rodan/rusia_neagra/README

power supply assy redesign for the Rusia Neagra MKII amplifier made by VIOTUBEAMP

https://www.tehnium-azi.ro/forums/topic/6689-proiectul-nr49-amplificatorul-rusia-neagra/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

pictures of the build are available here:
https://photos.app.goo.gl/SxAB8hwyef6rpiTH7
