rodan/rusia_neagra/ir/rusia_neagra_mk2_02.pdf

SIMPLEX | Titlul lucrării: Înregistrări termografice amplificator Rusia Neagra MKII feb 2020 | pag. 1
cod lucrare: CJ-01-20 | | actualizare 0

1

## BULETIN TERMOGRAFIC

T01 – 01 – CJ 01

SIMPLEX | pag. 2
feb 2020
| 0

2

low voltage power filter – the warm part is the full bridge rectifier

Ar1

23.0

40.1 °C

25

30

35

40

FLIR Systems

That pcb was replaced with a capacitor multiplier filter that also provides a tiny voltage drop that provides a much closer voltage to the ideal one needed by the valve heaters. Also the ripple was reduced from 400mV pk-pk to non-measurable levels.

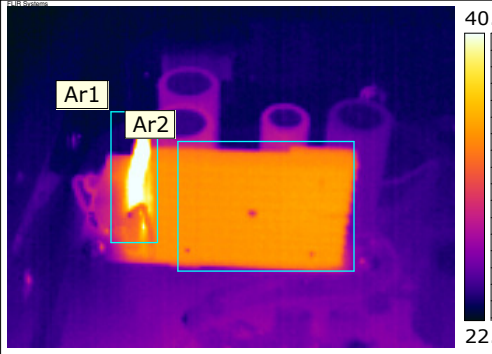
[picture p1: figure]

The hottest part is still the full bridge rectifier (Ar1 above), followed closely by the radiator (Ar2). The voltage drop of the circuit is about 1.6V.

Label | Value
IR: File Name | IR_6300.jpg
Ar1: Max | 38.1 °C
Label | Value
IR: File Name | IR_6320.jpg
IR: Max | 42.2 °C
Ar1: Max | 42.2 °C
Ar2: Max | 34.8 °C

22.8

40.0 °C

25

30

35

FLIR Systems

SIMPLEX | pag. 3
feb 2020
| 0

3

High voltage power source

The original PCB was a mosfet? based filter. Two of the resistors were found to be 70+ degrees above ambient:

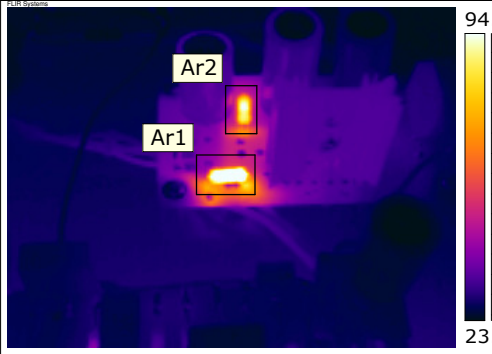
[picture p2: figure]

23.5

94.7 °C

40

60

80

FLIR Systems

It got replaced by a capacitor multiplier circuit that provides about 344V DC under load with no measurable ripple. The voltage drop between the input and the output of this circuit is about 2V, making the radiator almost redundant.

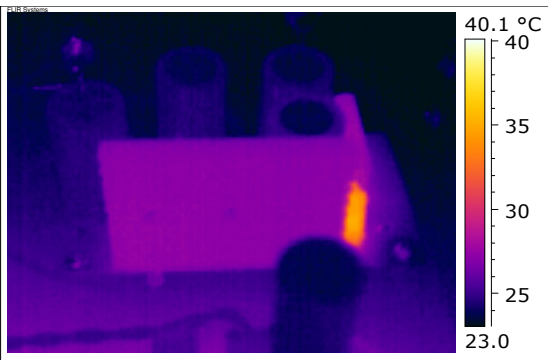
[picture p3: figure]
FLIR Systems

the hottest parts (15 degrees above ambient) are two 1Meg bleeder resistors - one placed on the input and one on the output.

Label | Value
IR: Date Of Creation | 2/9/2020
IR: Time Of Creation | 12:17:34 PM
IR: File Name | IR_6309.jpg
IR: Max | 105.4 °C
Ar1: Max | *105.5 °C
Ar2: Max | 96.1 °C
Label | Value
IR: File Name | IR_6322.jpg
IR: Max | 35.2 °C

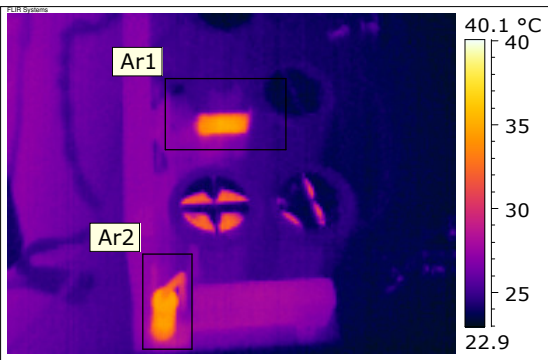
[picture p4: figure]
FLIR Systems

Label | Value
IR: File Name | IR_6321.jpg
IR: Max | 35.1 °C
Ar1: Max | 35.1 °C
Ar2: Max | 34.9 °C

SIMPLEX | pag. 4
feb 2020
| 0

4

Low wattage resistors in parallel with the triode’s heater

Sp1

23.9

52.6 °C

30

40

50

FLIR Systems

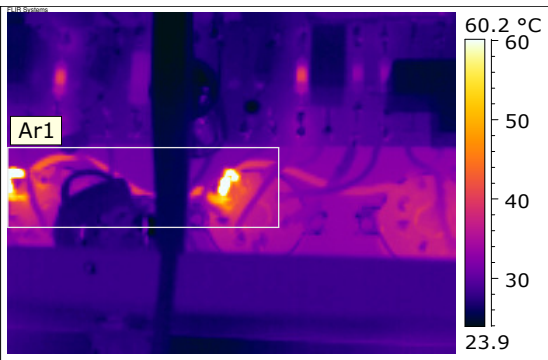
[picture p5: figure]
FLIR Systems

The 0.25W carbon resistors have been replaced with 5W wirewound ones:

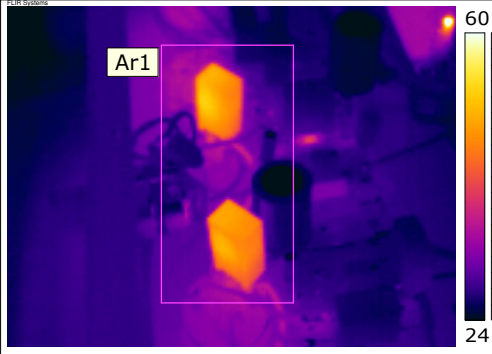
[picture p6: figure]

24.1

60.0 °C

30

40

50

FLIR Systems

Label | Value
IR: File Name | IR_6305.jpg
IR: Max | 104.9 °C
Sp1 | 103.2 °C
Label | Value
IR: File Name | IR_6306.jpg
Ar1: Max | 97.3 °C
Label | Value
IR: File Name | IR_6324.jpg
Ar1: Max | 52.8 °C

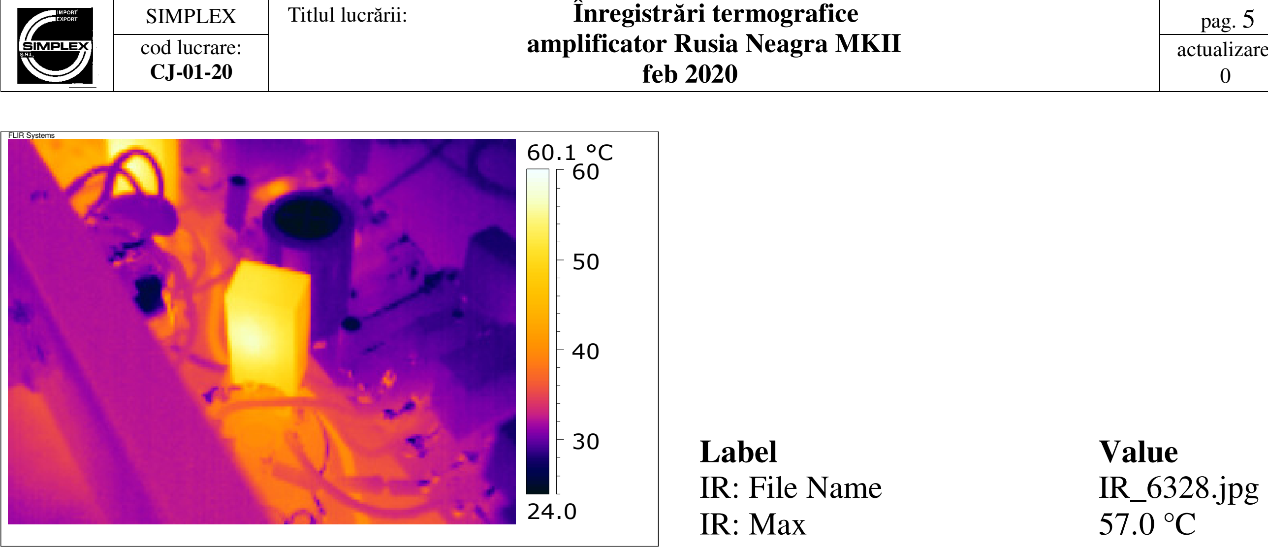
[picture p7: figure]
SIMPLEX; pag. 5; feb 2020; FLIR Systems; Label; Value; IR: File Name; IR_6328.jpg; IR: Max

5

SIMPLEX | pag. 6
feb 2020
| 0

6

LED resistors

21.2

56.2 °C

30

40

50

FLIR Systems

the 4K7 resistors were replaced with a 0.5W 47K one

Label | Value
IR: Date Of Creation | 2/9/2020
IR: Time Of Creation | 12:19:49 PM
IR: File Name | IR_6313.jpg
IR: Max | 72.0 °C
