rodan/rusia_neagra/ir/rusia_neagra_mk2_01.pdf

SIMPLEX | Titlul lucrării: Înregistrări termografice amplificator Rusia Neagra MKII feb 2020 | pag. 1
cod lucrare: CJ-01-20 | | actualizare 0

1

## BULETIN TERMOGRAFIC

T01 – 01 – CJ 01

SIMPLEX | pag. 2
feb 2020
| 0

2

low voltage power source – warm part is the full wave rectifier

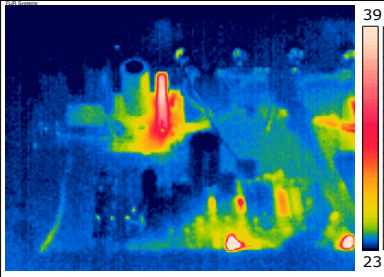
[picture p8: figure]

23.0

39.2 °C

25

30

35

FLIR Systems

high voltage power source – high wattage resistors

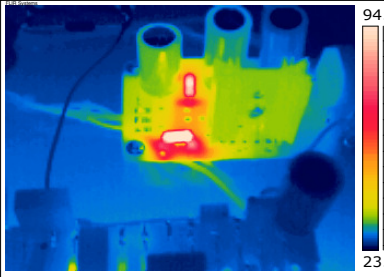
[picture p9: figure]

23.5

94.7 °C

40

60

80

FLIR Systems

low wattage resistors in parallel with the triode’s heater

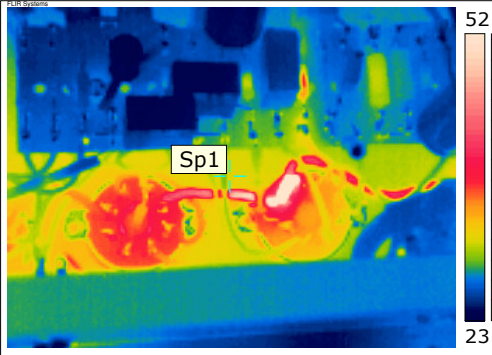
[picture p10: figure]

23.9

52.6 °C

30

40

50

FLIR Systems

Label | Value
IR: Date Of Creation | 2/9/2020
IR: Time Of Creation | 12:06:41 PM
IR: File Name | IR_6300.jpg
IR: Max | 85.7 °C
Label | Value
IR: Date Of Creation | 2/9/2020
IR: Time Of Creation | 12:17:34 PM
IR: File Name | IR_6309.jpg
IR: Max | 105.4 °C
Label | Value
IR: Date Of Creation | 2/9/2020
IR: Time Of Creation | 12:16:52 PM
IR: File Name | IR_6305.jpg
IR: Max | 104.9 °C

SIMPLEX | pag. 3
feb 2020
| 0

3

low wattage resistors in parallel with the triode’s heater

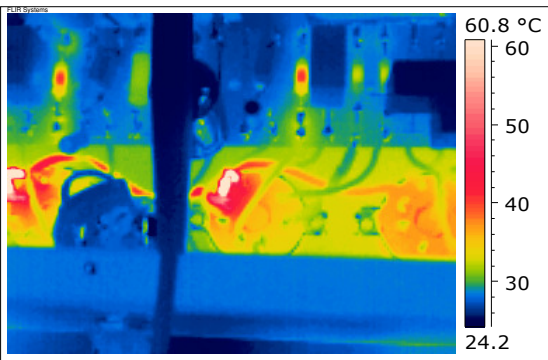
[picture p11: figure]
FLIR Systems

LED resistors

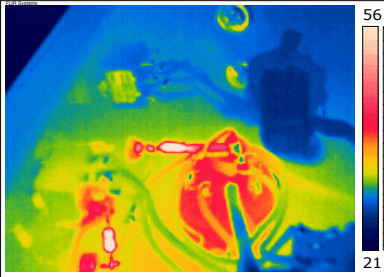
[picture p12: figure]

21.2

56.2 °C

30

40

50

FLIR Systems

Label | Value
IR: Date Of Creation | 2/9/2020
IR: Time Of Creation | 12:17:05 PM
IR: File Name | IR_6306.jpg
IR: Max | 97.3 °C
Label | Value
IR: Date Of Creation | 2/9/2020
IR: Time Of Creation | 12:19:49 PM
IR: File Name | IR_6313.jpg
IR: Max | 72.0 °C
