rodan/rusia_neagra/ltspice/ripple_filter_neg_bipolar.asc

C1: cap; 1000µ
C2: cap; 6600µ
C4: cap; 3300µ
D1: diode
Q1: pnp; BD140
Q2: pnp; 2SA1943
R1: res; 2K
R2: res; 100k
R3: res; 60
R4: res; 3K
R5: res; 10k
R6: res; 100k
V1: voltage; PULSE(39.5 38.5 0 2ms 8ms 0.01ms 10ms)
Named nets: 0, -Vin, -Vout
.tran 0 60s 59900ms
.include 2sa1943.lib
.include bd140.lib
