rodan/rusia_neagra/ltspice/ripple_filter_neg_mosfet.asc

C1: cap; 1µ
C2: cap; 4700µ
C3: cap; 220µ
D1: diode
M1: pmos; IRFP9240
R1: res; 220
R2: res; 10k
R3: res; 1.5
R4: res; 30
V1: voltage; PULSE(39.5 38.5 0 2ms 8ms 0.01ms 10ms)
Named nets: 0, -Vin, -Vout
.tran 0 10s 9940ms
