rodan/rusia_neagra/ltspice/ripple_filter_pos_bipolar.asc

C1: cap; 120µ
C2: cap; 240µ
C3: cap; 120µ
D1: diode
Q1: npn; 2SC5658
Q2: npn; BC547C
R1: res; 100k
R2: res; 22k
R3: res; 600
R4: res; 30k
R5: res; 1Meg
R6: res; 22k
V1: voltage; PULSE(320 310 0 2ms 8ms 0.01ms 10ms)
Named nets: 0, Vin, Vout
.tran 0 10s 9960ms
