rodan/rusia_neagra/ltspice/original_filter.asc

C1: cap; 100µ
C2: cap; 68µ
D1: zener; BZX84C12L
M1: nmos; IRFP240
R1: res; 650k
R3: res; 30k
R4: res; 100k
V1: voltage; PULSE(345 340 0 20ms 80ms 0 100ms)
Named nets: 0, Vin, Vout
.tran 0 10s 9500ms
