rodan/rusia_neagra/ltspice/ripple_filter_pos_mosfet.asc

C1: cap; 220µ
C2: cap; 4700µ
C3: cap; 1µ
D1: diode
M1: nmos; IRFP240
R1: res; 10K
R2: res; 220
R3: res; 20
R4: res; 1.5
V1: voltage; PULSE(18 21 0 2ms 8ms 0.01ms 10ms)
Named nets: 0, Vin, Vout
.tran 0 10s 9960ms
