rodan/rusia_neagra/pwr_pos_bipolar.brd

## EAGLE design pwr_pos_bipolar.brd (2020-05-01)

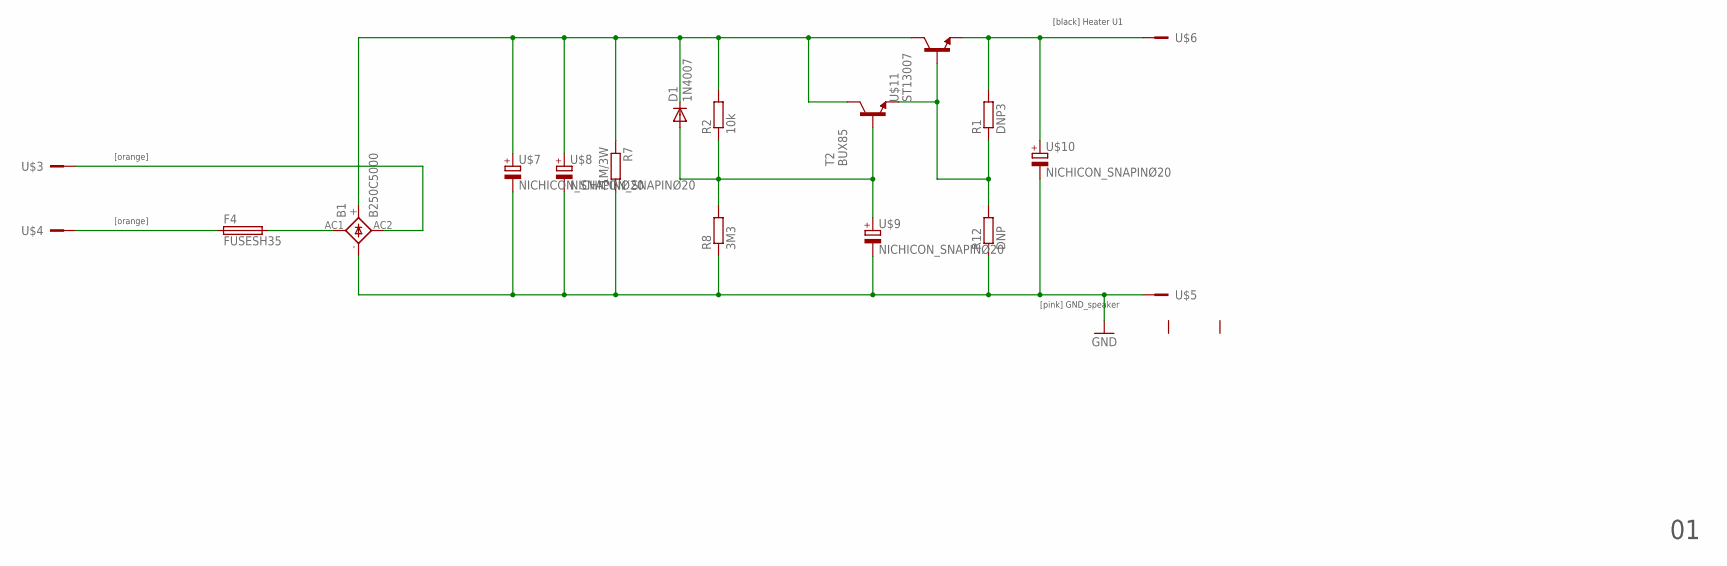
[picture p13: schematic pwr_pos_bipolar.sch, Power Assy - Positive bipolar]

Parts:
B1: B250C5000; DIOTEC_BC5000
D1: 1N4007; DO41-10
F4: FUSESH35; SH25
R1: DNP3; 0411/12
R2: 10k; 0411/12
R7: 1M/3W; 0922V
R8: 3M3; 0411/12
R12: DNP; 0411/12
T2: BUX85; TO220V
U$1: SK456-60-3XM3L
U$2: RN_POWER; RN
U$3, U$4, U$5, U$6: M1; M1_OFFSET
U$7, U$8, U$9, U$10: NICHICON_SNAPINØ20; C_20G10
U$11: ST13007; TOP3V_TO220

Connections:
30VAC_1: B1.AC2, U$3.1
30VAC_2: F4.1, U$4.1
GND: B1.-, R7.2, R8.1, R12.1, U$5.1, U$7.-, U$8.-, U$9.-, U$10.-
unnamed: B1.AC1, F4.2
unnamed: R1.1, R12.2, T2.3 (E), U$11.B, U$11.B$1 (B)
unnamed: D1.A, R2.1, R8.2, T2.1 (B), U$9.+
N_C: B1.+, D1.C, R2.2, R7.1, T2.2 (C), U$7.+, U$8.+, U$11.C
V-: R1.2, U$6.1, U$10.+, U$11.E, U$11.E$1 (E)

Notes on the sheet:
[orange]
[pink] GND_speaker
[black] Heater U1

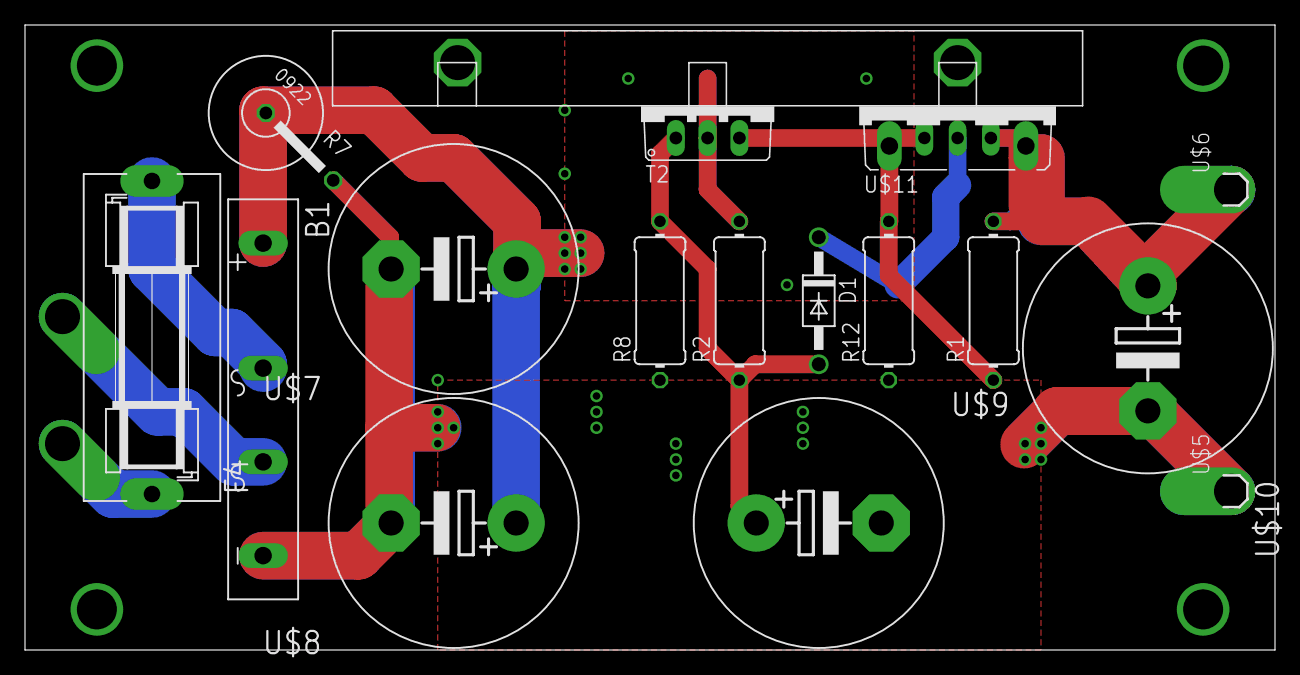
[picture p14: board pwr_pos_bipolar.brd from above]

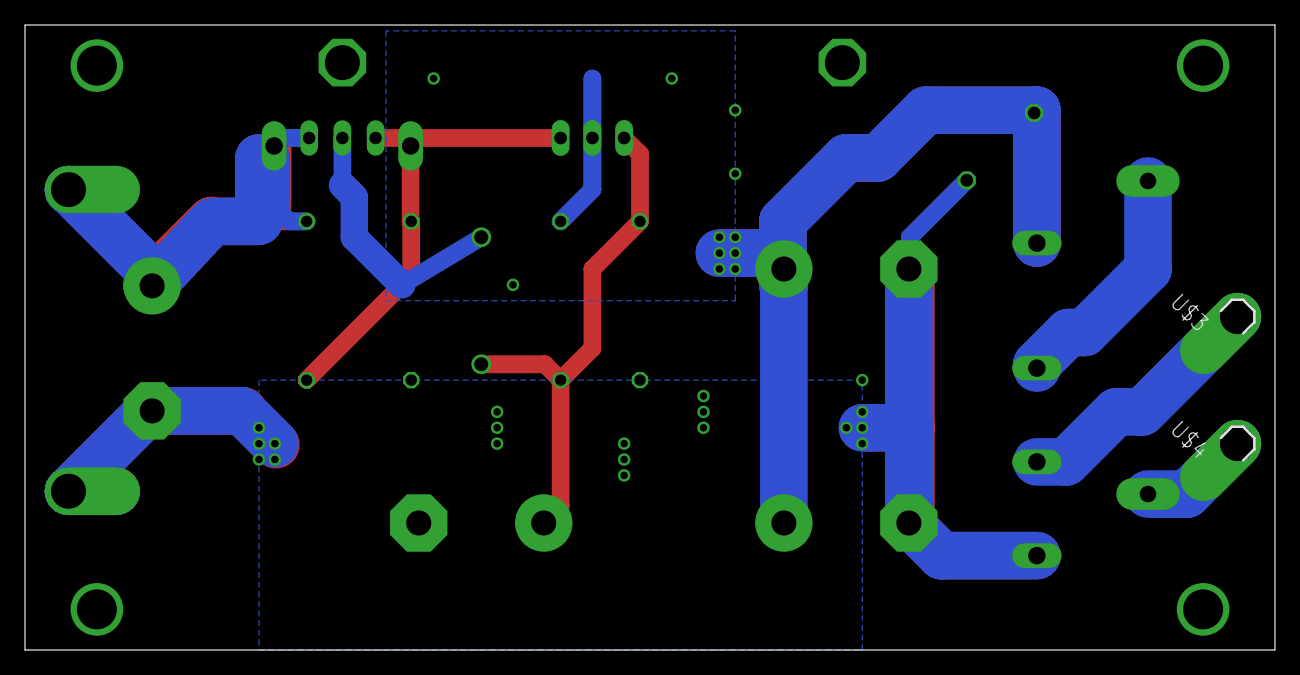
[picture p15: board pwr_pos_bipolar.brd from below]

Board: 2 copper layers, 100.0 x 50.0 mm, 20 parts (2 on the bottom side), 8 nets.
