rodan/rusia_neagra/pwr_neg_bipolar.brd

## EAGLE design pwr_neg_bipolar.brd (2020-04-26)

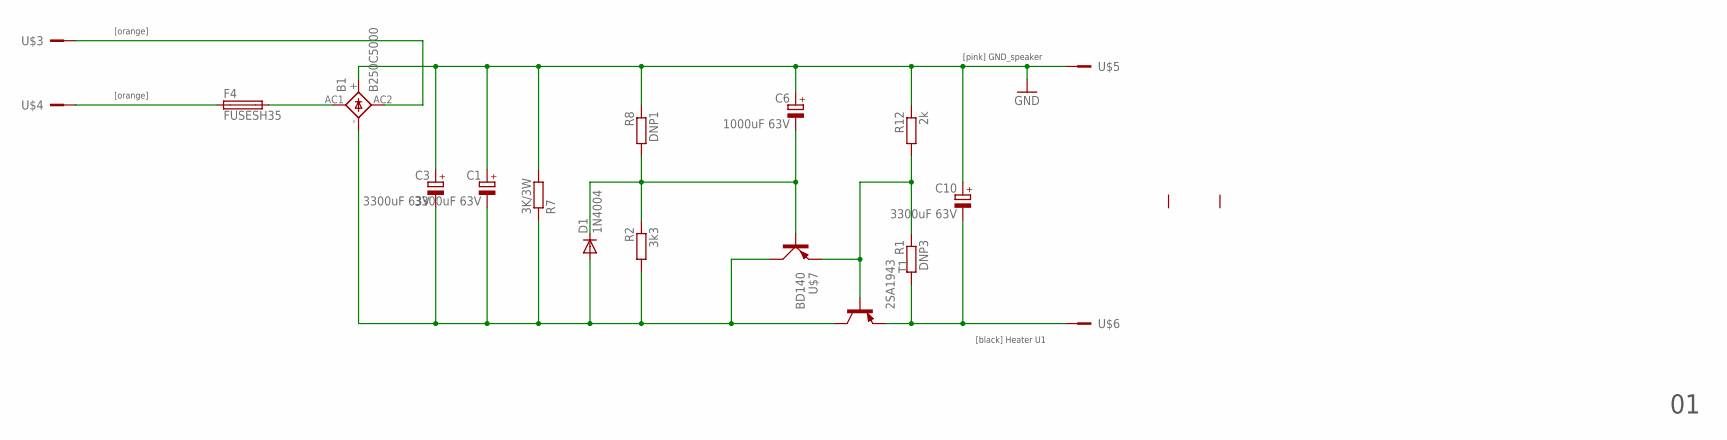
[picture p16: schematic pwr_neg_bipolar.sch, Power Assy - negative bipolar]

Parts:
B1: B250C5000; DIOTEC_BC5000
C1, C3, C10: 3300uF 63V; EB20D
C6: 1000uF 63V; E7,5-16
D1: 1N4004; DO41-10
F4: FUSESH35; SH25
R1: DNP3; 0411/12
R2: 3k3; 0411/12
R7: 3K/3W; 0922V
R8: DNP1; 0411/12
R12: 2k; 0411/12
T1: 2SA1943; TOP3V
U$1: SK456-60-3XM3L
U$2: RN_POWER; RN
U$3, U$4, U$5, U$6: M1; M1_OFFSET
U$7: BD140; SOT32

Connections:
30VAC_1: B1.AC2, U$3.1
30VAC_2: F4.1, U$4.1
GND: B1.+, C1.+, C3.+, C6.+, C10.+, R7.2, R8.1, R12.1, U$5.1
unnamed: B1.AC1, F4.2
unnamed: R1.1, R12.2, T1.B, U$7.E
unnamed: C6.-, D1.C, R2.1, R8.2, U$7.B
N_C: B1.-, C1.-, C3.-, D1.A, R2.2, R7.1, T1.C, U$7.C
V-: C10.-, R1.2, T1.E, U$6.1

Notes on the sheet:
[orange]
[pink] GND_speaker
[black] Heater U1

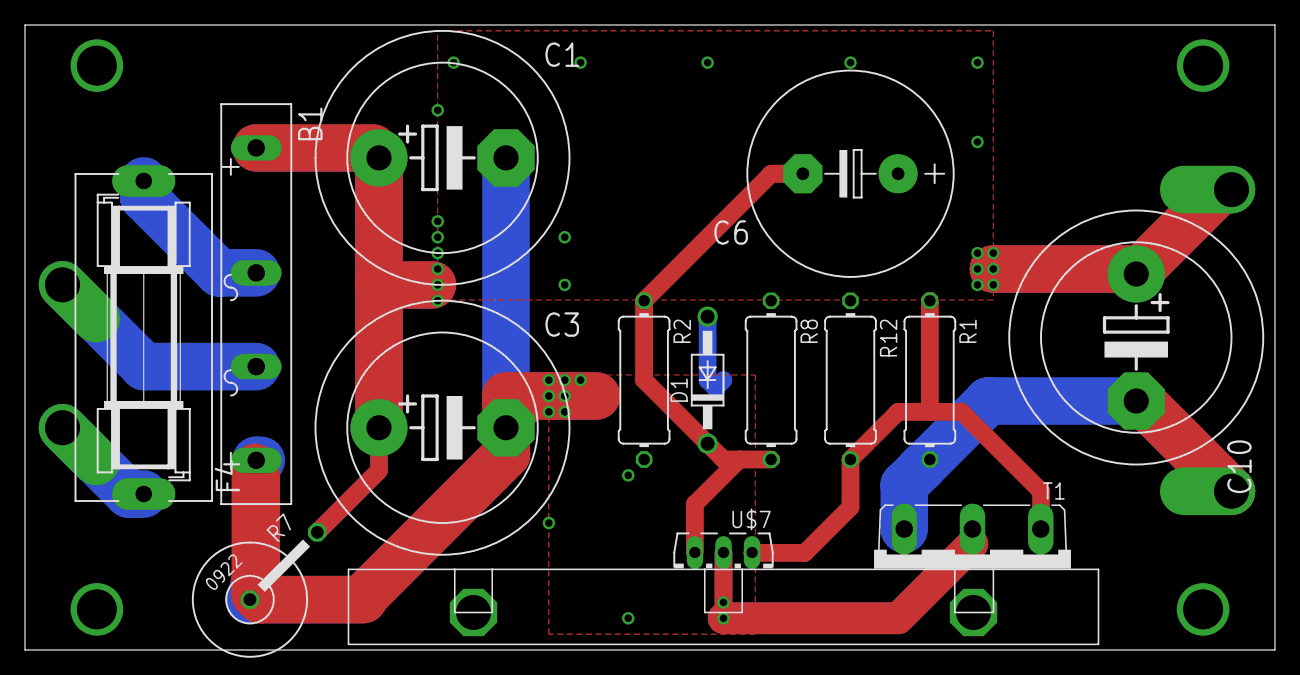
[picture p17: board pwr_neg_bipolar.brd from above]

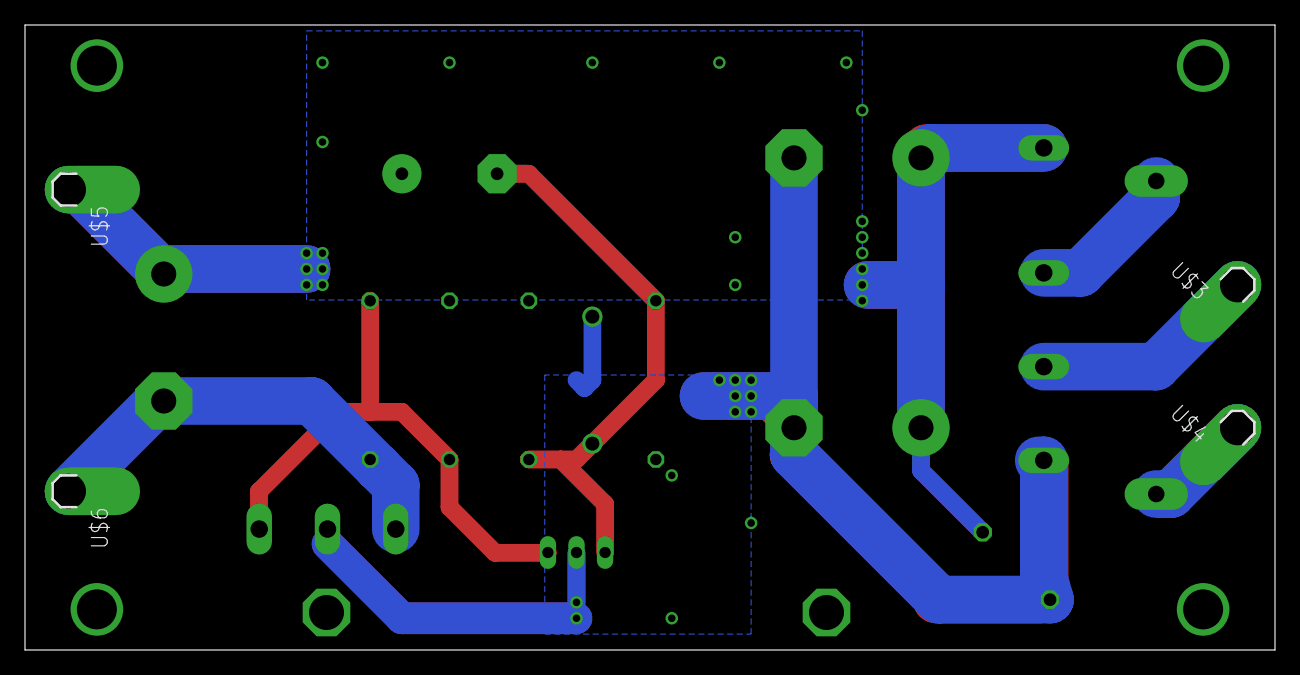
[picture p18: board pwr_neg_bipolar.brd from below]

Board: 2 copper layers, 100.0 x 50.0 mm, 20 parts (4 on the bottom side), 8 nets.
