rodan/rusia_neagra/rn_mk2.brd

## EAGLE design rn_mk2.brd (2020-03-02)

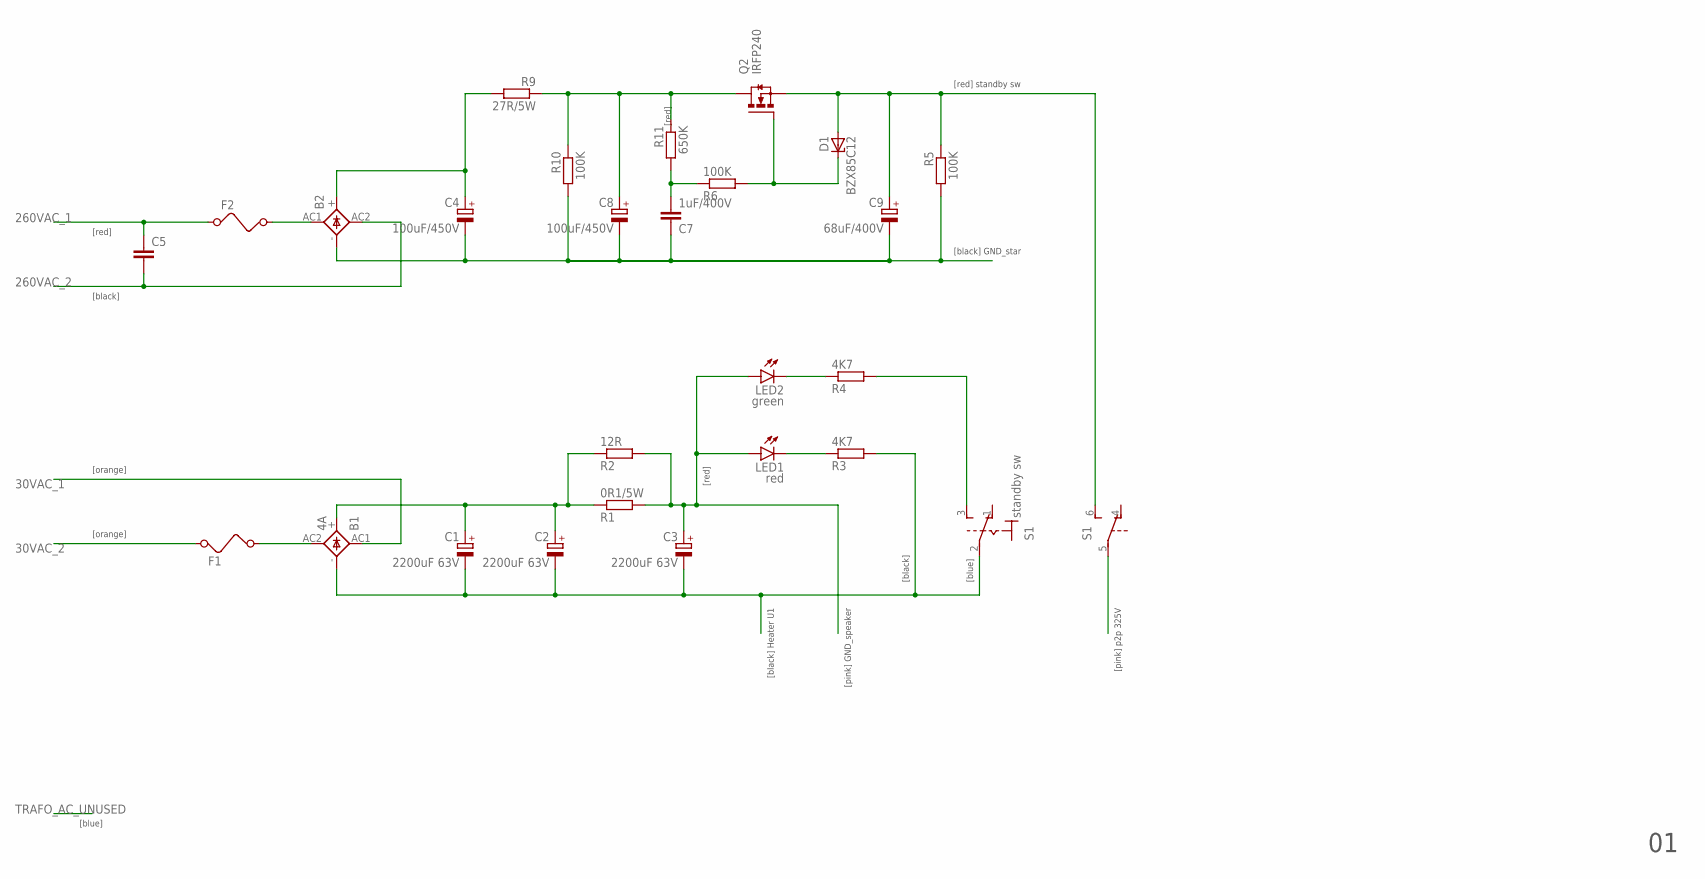
[picture p19: schematic rn_mk2.sch, sheet 1, Rusia Neagra MKII power pcb]

Parts:
B1: 4A; DIOTEC_BC5000
B2: DIOTEC_BC5000
C1, C2, C3: 2200uF 63V; E7,5-18
C4, C8: 100uF/450V; E7,5-18
C5: C-EU075-032X103; C075-032X103
C7: 1uF/400V; C075-032X103
C9: 68uF/400V; E7,5-18
D1: BZX85C12; DO41Z10
F1, F2: FUSE
LED1: red; LED3MM
LED2: green; LED3MM
Q2: IRFP240; TO247BV
R1: 0R1/5W; 0922/22
R2: 12R; 0922/22
R3, R4: 4K7; 0922/22
R5, R6, R10: 100K; 0922/22
R9: 27R/5W; 0922/22
R11: 650K; 0922/22
S1: standby sw; 320-938

Connections:
30VAC_1: B1.AC1
30VAC_2: F1.1
260VAC_1: C5.1, F2.1
260VAC_2: B2.AC2, C5.2
unnamed: B1.-, C1.-, C2.-, C3.-, R3.2, S1.2
unnamed: B1.AC2, F1.2
unnamed: B1.+, C1.+, C2.+, R1.1, R2.1
unnamed: C3.+, LED1.A, LED2.A, R1.2, R2.2
unnamed: LED1.K (C), R3.1
unnamed: LED2.K (C), R4.1
unnamed: R4.2, S1.3 (S)
unnamed: B2.AC1, F2.2
unnamed: B2.+, C4.+, R9.2
unnamed: B2.-, C4.-, C7.1, C8.-, C9.-, R5.2, R10.2
unnamed: C8.+, Q2.D, R9.1, R10.1, R11.1
unnamed: C7.2, R6.1, R11.2
unnamed: D1.C, Q2.G, R6.2
unnamed: C9.+, D1.A, Q2.S, R5.1, S1.6 (S)

Notes on the sheet:
[orange]
[pink] GND_speaker
[black] Heater U1
[red]
[blue]
[black]
[black] GND_star
[red] standby sw
[pink] p2p 325V

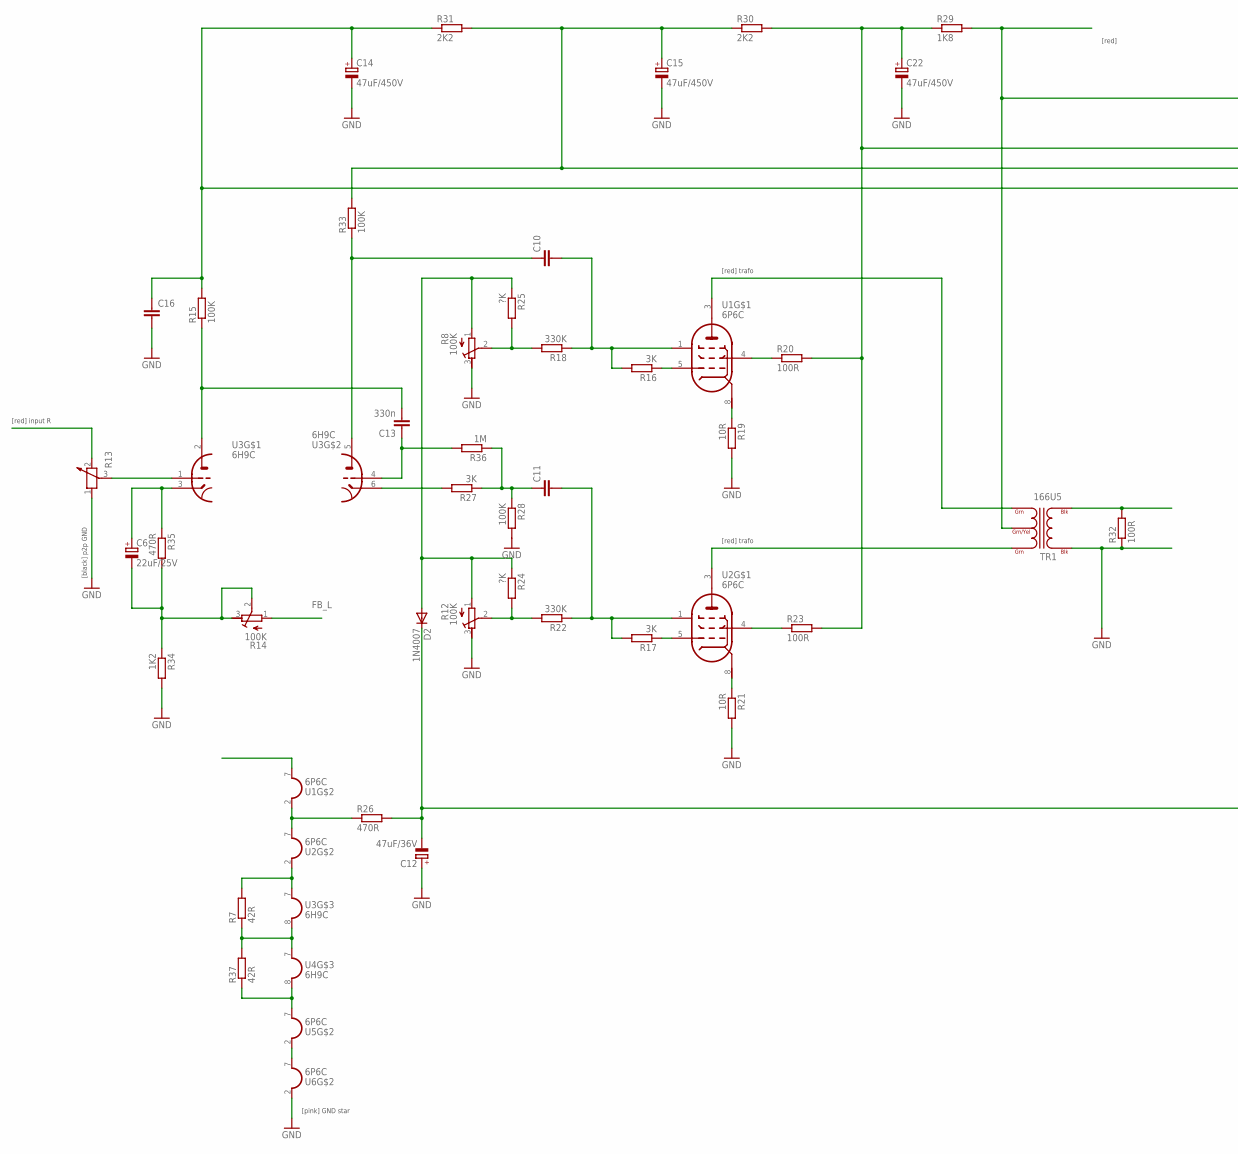
[picture p20: schematic rn_mk2.sch, sheet 2, Rusia Neagra MKII main point to point, part in row 1, column 1]

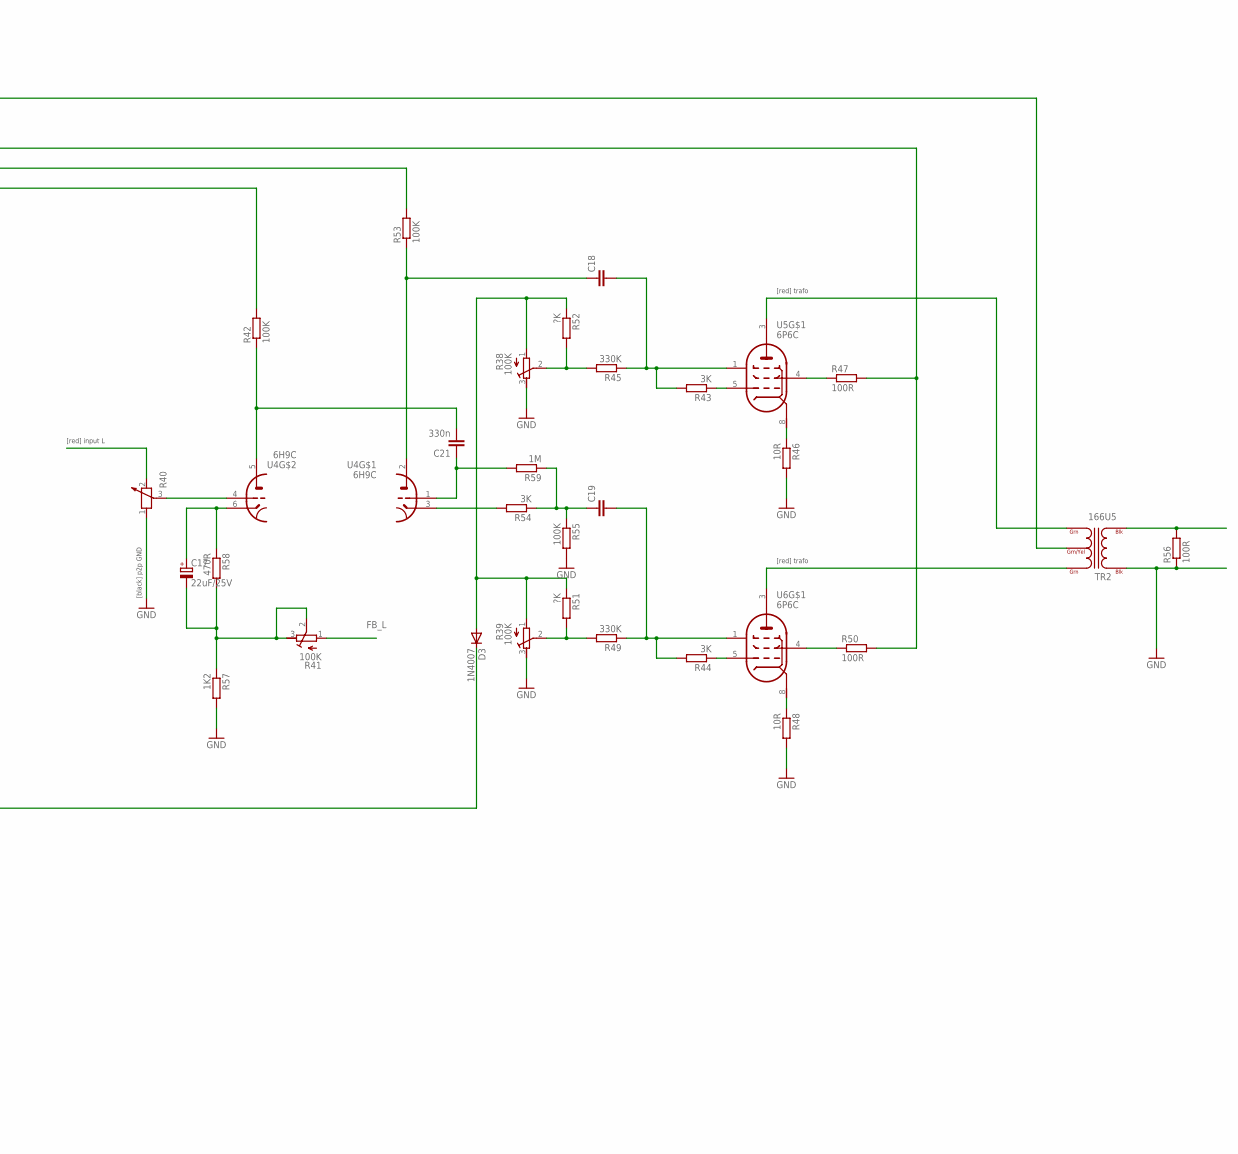
[picture p21: schematic rn_mk2.sch, sheet 2, Rusia Neagra MKII main point to point, part in row 1, column 2]

Parts:
C6, C17: 22uF/25V; E5-5
C10, C11, C16, C18, C19: C-EU150-054X183; C150-054X183
C12: 47uF/36V; E5-5
C13, C21: 330n; C150-054X183
C14, C15, C22: 47uF/450V; E5-5
D2, D3: 1N4007; DO41-10
R7, R37: 42R; 0414/15
R8, R12, R14, R38, R39, R41: 100K; RTRIM64Y
R13, R40: POTENTIOMETER_PT-10; PT-10
R15, R28, R33, R42, R53, R55: 100K; 0414/15
R16, R17, R27, R43, R44, R54: 3K; 0414/15
R18, R22, R45, R49: 330K; 0414/15
R19, R21, R46, R48: 10R; 0414/15
R20, R23, R32, R47, R50, R56: 100R; 0414/15
R24, R25, R51, R52: ?K; 0414/15
R26: 470R; 0922/22
R29: 1K8; 0414/15
R30, R31: 2K2; 0414/15
R34, R57: 1K2; 0414/15
R35, R58: 470R; 0414/15
R36, R59: 1M; 0414/15
TR1, TR2: 166U5; C14H
U1, U2, U5, U6: 6P6C; OKTAL
U3, U4: 6H9C; OKTAL

Connections:
FB_L: R14.1 (A), R41.1 (A)
GND: C12.+, C14.-, C15.-, C16.2, C22.-, R8.3 (E), R12.3 (E), R13.1, R19.2, R21.2, R28.2, R32.1, R34.2, R38.3 (E), R39.3 (E), R40.1, R46.2, R48.2, R55.2, R56.1, R57.2, TR1.BLK@1 (BLK), TR2.BLK@1 (BLK), U6.2 (H1)
unnamed: R26.1, U1.2 (H1), U2.7 (H2)
unnamed: R7.2, U2.2 (H1), U3.7 (H1)
unnamed: R7.1, R37.2, U3.8 (H2), U4.7 (H1)
unnamed: R13.3, U3.1 (TG1)
unnamed: R16.1, U1.5 (PG)
unnamed: C13.2, R15.1, U3.2 (TA1)
unnamed: C6.+, R35.1, U3.3 (T1)
unnamed: C13.1, R36.2, U3.4 (TG2)
unnamed: C10.2, R16.2, R18.1, U1.1 (SH)
unnamed: R17.1, U2.5 (PG)
unnamed: C11.2, R17.2, R22.1, U2.1 (SH)
unnamed: C10.1, R33.1, U3.5 (TA2)
unnamed: TR1.GRN@2 (GRN), U1.3 (PA)
unnamed: R8.2 (S), R18.2, R25.2
unnamed: R19.1, U1.8 (PK)
unnamed: R20.1, U1.4 (PSG)
unnamed: D2.A, R8.1 (A), R12.1 (A), R24.1, R25.1
unnamed: TR1.GRN@1 (GRN), U2.3 (PA)
unnamed: R21.1, U2.8 (PK)
unnamed: R12.2 (S), R22.2, R24.2
unnamed: C12.-, D2.C, D3.C, R26.2
unnamed: R23.1, U2.4 (PSG)
unnamed: R40.3, U4.4 (TG2)
unnamed: C11.1, R27.1, R28.1, R36.1
unnamed: R27.2, U3.6 (T2)
unnamed: C15.+, R30.1, R31.2, R33.2, R53.2
unnamed: U5.2 (H1), U6.7 (H2)
unnamed: C22.+, R20.2, R23.2, R29.1, R30.2, R47.2, R50.2
unnamed: C6.-, R14.2 (S), R14.3 (E), R34.1, R35.2
unnamed: C14.+, C16.1, R15.2, R31.1, R42.2
unnamed: R32.2, TR1.BLK@2 (BLK)
unnamed: R37.1, U4.8 (H2), U5.7 (H2)
unnamed: R54.2, U4.3 (T1)
unnamed: C21.2, R42.1, U4.5 (TA2)
unnamed: C17.+, R58.1, U4.6 (T2)
unnamed: R43.1, U5.5 (PG)
unnamed: C18.2, R43.2, R45.1, U5.1 (SH)
unnamed: R44.1, U6.5 (PG)
unnamed: C19.2, R44.2, R49.1, U6.1 (SH)
unnamed: C18.1, R53.1, U4.2 (TA1)
unnamed: R46.1, U5.8 (PK)
unnamed: R47.1, U5.4 (PSG)
unnamed: D3.A, R38.1 (A), R39.1 (A), R51.1, R52.1
unnamed: R48.1, U6.8 (PK)
unnamed: R39.2 (S), R49.2, R51.2
unnamed: R50.1, U6.4 (PSG)
unnamed: R29.2, TR1.GRN/YEL, TR2.GRN/YEL
unnamed: R38.2 (S), R45.2, R52.2
unnamed: TR2.GRN@1 (GRN), U6.3 (PA)
unnamed: TR2.GRN@2 (GRN), U5.3 (PA)
unnamed: C19.1, R54.1, R55.1, R59.1
unnamed: R56.2, TR2.BLK@2 (BLK)
unnamed: C17.-, R41.2 (S), R41.3 (E), R57.1, R58.2
unnamed: C21.1, R59.2, U4.1 (TG1)

Notes on the sheet:
[black] p2p GND
[red] input R
[red] trafo
[red]
[red] input L
[pink] GND star

Board: 2 copper layers, 99 parts (6 on the bottom side), 72 nets, no tracks yet.
