rodan/rusia_neagra/(commit log)

2020-04-19 ripple filter built and tested
    [pwr_neg_bipolar.sch, pwr_pos_bipolar.brd, pwr_pos_bipolar.sch, rn_mk2.sch]
2020-05-01 build done
    [pwr_pos_bipolar.brd, pwr_pos_bipolar.sch]
