rodan/rusia_neagra/(notices)

Notices in the files:
parts and their libraries:
SparkFun-LED: Licensing: Creative Commons ShareAlike 4.0 International - https://creativecommons.org/licenses/by-sa/4.0
